chs8691/DynamoDrivenOdometer/Documentation/Version 1.1/fotos/IMG_7320.JPG

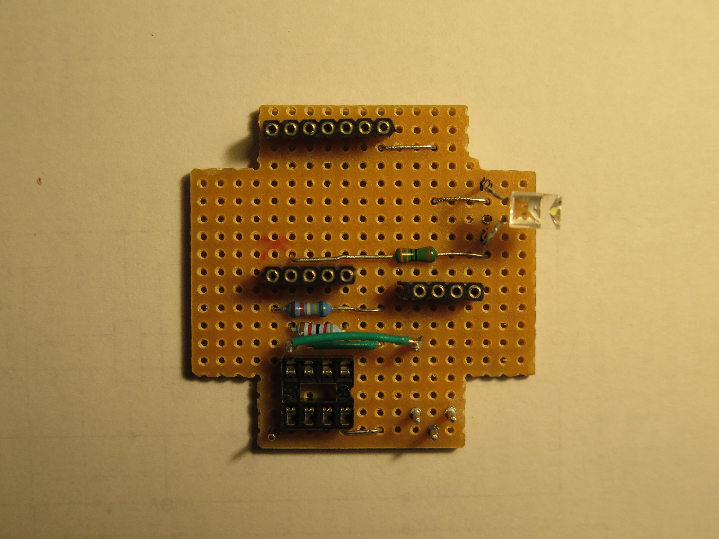
Documentation/Version 1.1/fotos/IMG_7320.JPG
