chs8691/DynamoDrivenOdometer/README.md

DynamoDrivenOdometer
====================

Bike odometer only driven by dynamo, connected to a Android app
