chs8691/DynamoDrivenOdometer/Module_PSM_PowerSupplyModule/141022_Breadboard_PSM_V2.0.pptx

M1 Pololu 3.3V Step-Up Voltage Regulator U1V11F3
IC2 Brückengleichrichter
C1 100 nF
C2 10 myF
IC1 Spannungregler LD1117V33C

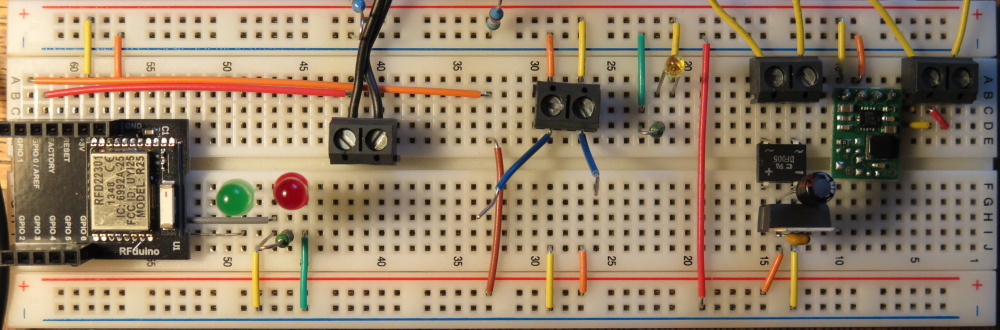
[picture p3: figure]

VDynamo ~ 6V

VFrontLED = 3V

IC2

M1

IC1

C1

C2
