chs8691/DynamoDrivenOdometer/Module_PSM_PowerSupplyModule/140720_BreadBoard.pptx

d

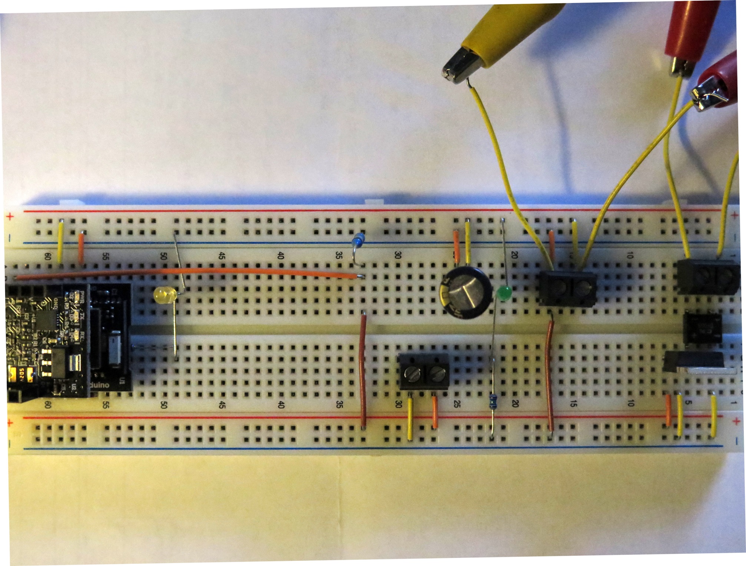
[picture p4: figure]

R1, R2 165 Ω
D1, D2 LED
R3 55 kΩ
C1 1000 μF
A1 Bridge Rectifier DF005-G
A2 Voltage Regulator 3,6 V
B&M Lumoteq IQ:
V1 LED Power Supply
V2 Taillight Power Supply

V1-

V1+

V2~

GPIO1

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
GPIO2

R2
