chs8691/DynamoDrivenOdometer/Module_RST_ReedSwitchTrigger/BreadBoard.pptx

R1 165 Ω
D1 LED
R2 320 Ω – Pulldown Resistor
V1 B&M Lumoteq LED Power Supply

Reed

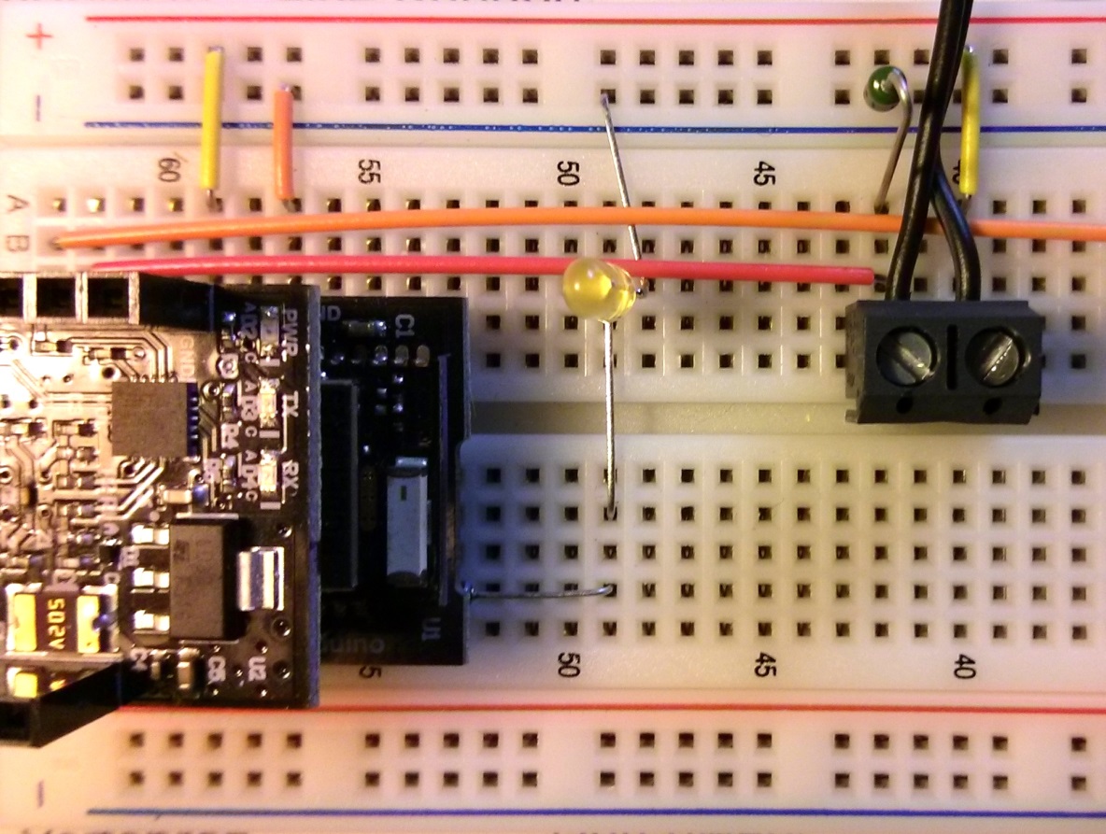
[picture p5: figure]

V1

GPIO0

R2

C1

R1

GPIO2
