chs8691/DynamoDrivenOdometer/Documentation/Version 1.1/BreadBoard.pptx

M1 RFD22102 RFduino DIP
M2 Pololu 3.3V Step-Up Voltage Regulator U1V11F3
IC1 EEPROM Microship 24AA256
R4 Vorwiderstand 82 kΩ
LED1 Rote LED
R1 Vorwiderstand 330 Ω
LED2 Gelbe LED
R2 Vorwiderstand 330 Ω
R3 Pull-Down-Widerstand 55 k Ω

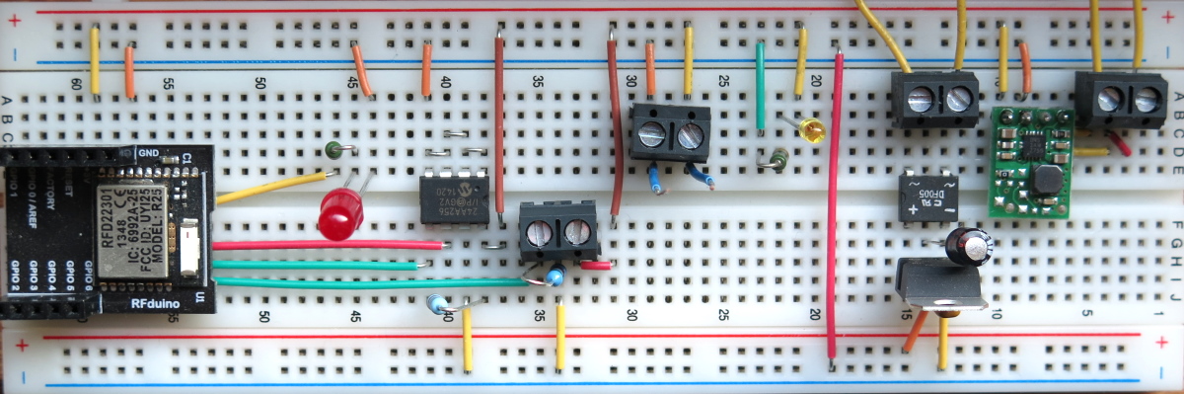
[picture p6: figure]

VFrontLED = 3V

Reed-Switch

Nicht
verwendet

M1

R1

IC1

R2

LED2

M2

LED1

R4

R3
