chs8691/DynamoDrivenOdometer/Documentation/System Context.jpg

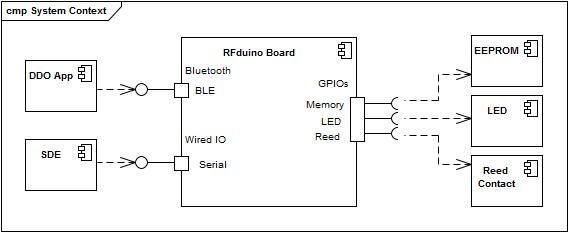
Documentation/System Context.jpg
