chs8691/DynamoDrivenOdometer/Documentation/Version 1.1/Blog/2014-11-18 11_31_23-TinyCad - [tCad1.dsn].jpg

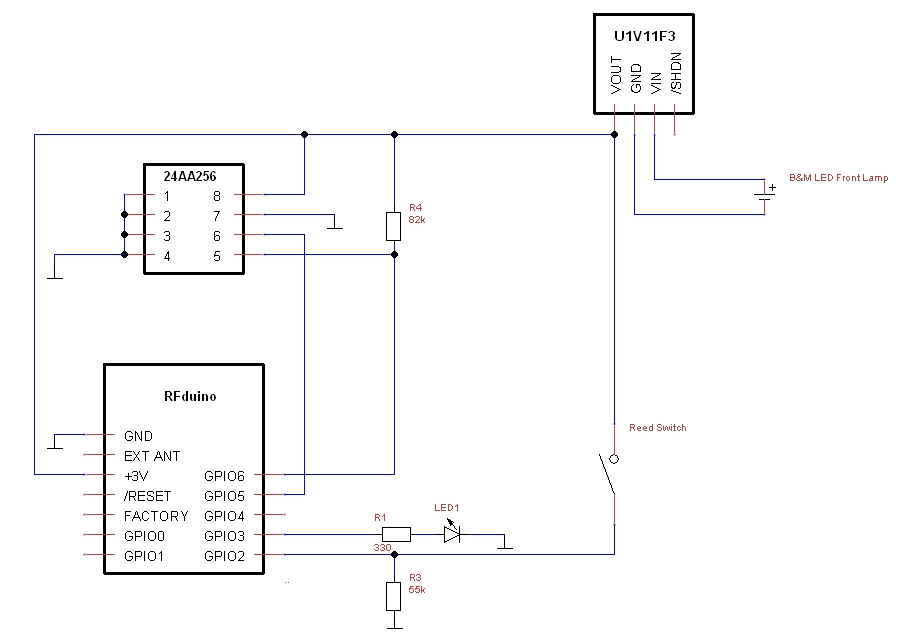
Documentation/Version 1.1/Blog/2014-11-18 11_31_23-TinyCad - [tCad1.dsn].jpg
