chs8691/DynamoDrivenOdometer/Documentation/Version 1.1/Blog/2014-11-20 11_11_35-Clipboard.jpg

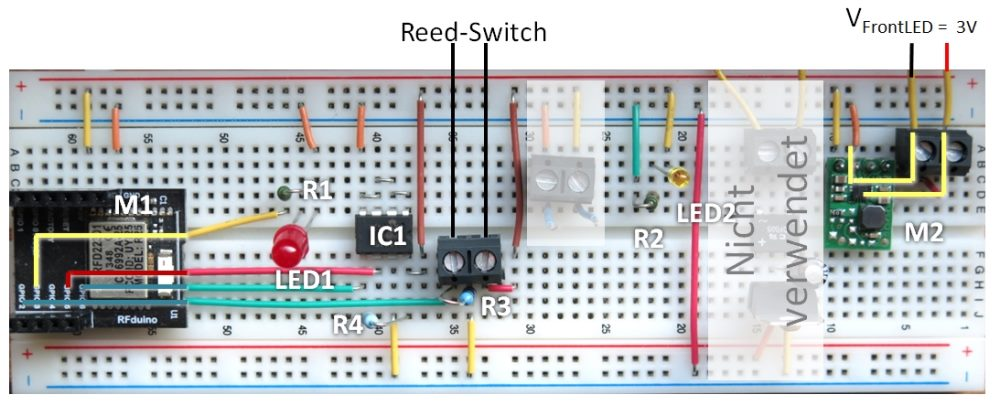
Documentation/Version 1.1/Blog/2014-11-20 11_11_35-Clipboard.jpg
