chs8691/DynamoDrivenOdometer/Documentation/Version 1.1/Blog/2014-11-20 11_23_54-TinyCad - [tCad2.dsn].jpg

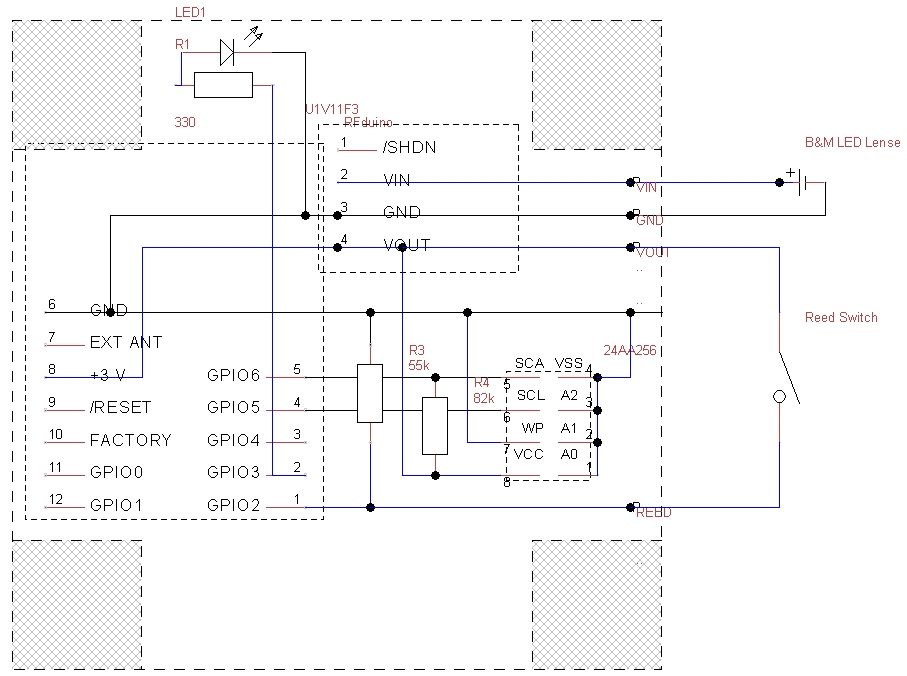
Documentation/Version 1.1/Blog/2014-11-20 11_23_54-TinyCad - [tCad2.dsn].jpg
