chs8691/DynamoDrivenOdometer/Documentation/Version 1.1/Blog/DSC00612.JPG

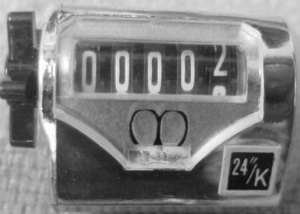
Documentation/Version 1.1/Blog/DSC00612.JPG
