chs8691/DynamoDrivenOdometer/Documentation/Version 1.1/fotos/Breadboard_Prototyp.jpg

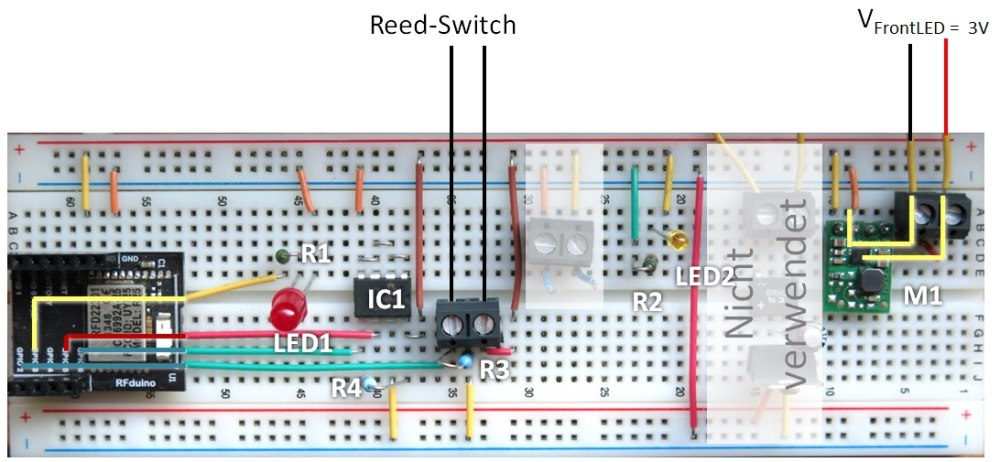
Documentation/Version 1.1/fotos/Breadboard_Prototyp.jpg
