chs8691/DynamoDrivenOdometer/Documentation/Version 1.1/fotos/IMG_7326.JPG

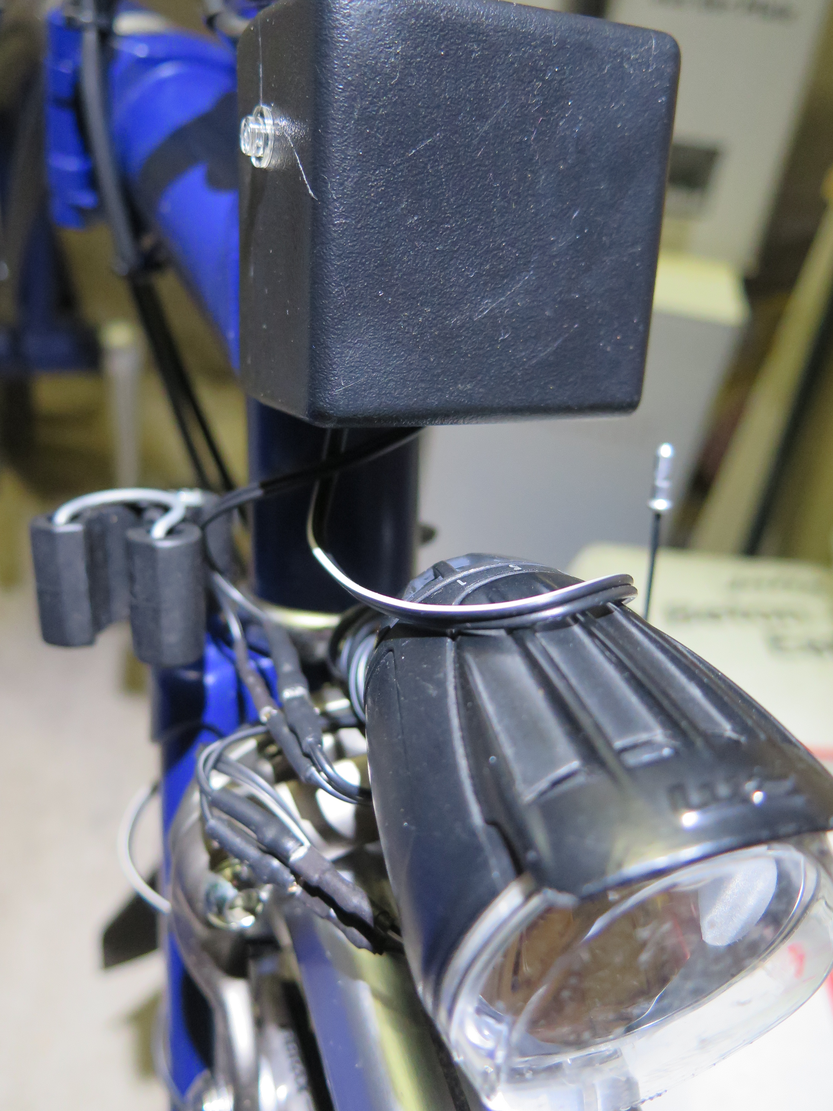
Documentation/Version 1.1/fotos/IMG_7326.JPG
