chs8691/DynamoDrivenOdometer/Documentation/Version 1.1/IMG_20140803_080237.jpg

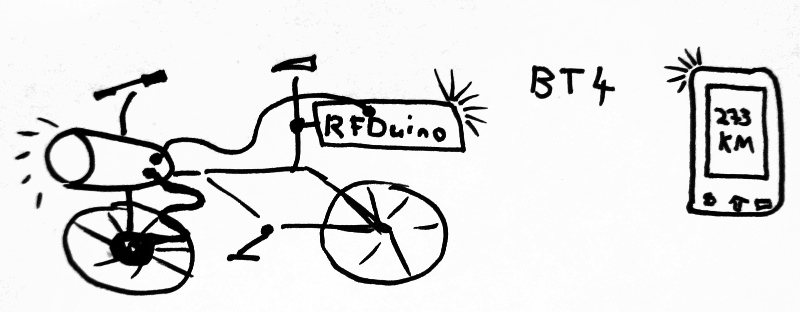
Documentation/Version 1.1/IMG_20140803_080237.jpg
