chs8691/DynamoDrivenOdometer/Documentation/Version 1.1/Stückliste.xlsx

Position | Bezeichnung | Herkunft | Link
M1 | RFD22102 RFduino DIP | Mouser Electronics | http://www.rfduino.com/
M2 | Pololu 3.3V Step-Up Voltage Regulator U1V11F3
IC1 | EEPROM Microship 24AA257
R4 | Vorwiderstand 82 kΩ
LED1 | Rote LED
R1 | Vorwiderstand 330 Ω
LED2 | Gelbe LED
R2 | Vorwiderstand 330 Ω
R3 | Pull-Down-Widerstand 55 k Ω
