chs8691/DynamoDrivenOdometer/Documentation/Components.jpg

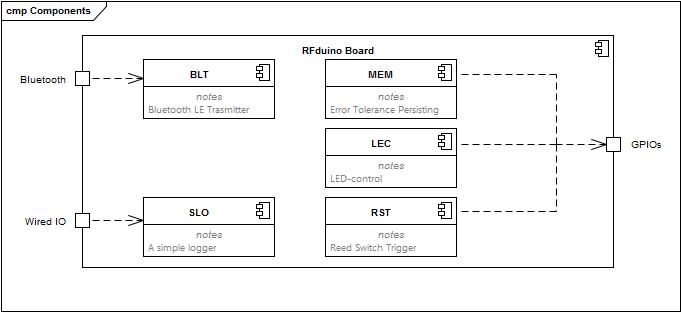
Documentation/Components.jpg
