chs8691/DynamoDrivenOdometer/(list of files, drawings)

Other design files:
Documentation/tCad2.dsn
Documentation/Version 1.1/Schaltung/tCad1.dsn
Documentation/Version 1.1/Schaltung/tCad2.dsn
