chs8691/DynamoDrivenOdometer/(commit log)

2014-09-13 Resistor value changed.
2014-10-22 Power supply Version 2.0.
2014-11-07 Circuit added.
    [tCad1.dsn, tCad2.dsn]
2014-11-25 Add documentation for blogger
    [Stückliste.xlsx, tCad1.dsn, tCad2.dsn]
